giang-hoangnguyen/MM_Control/enclosure/stl/Enclosure_Top_print.stl

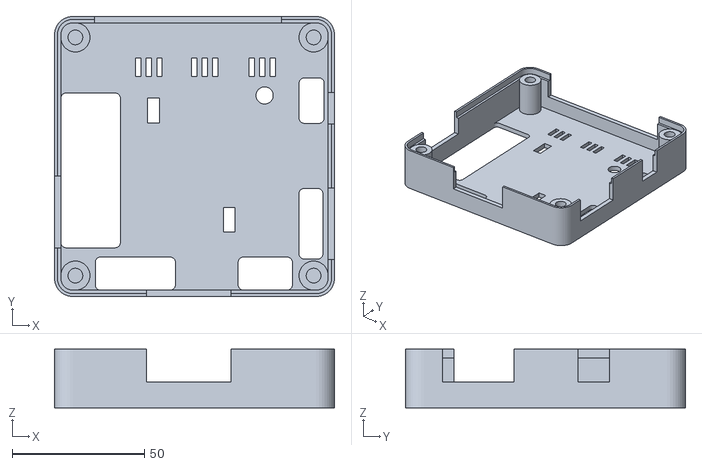
[picture p14: CAD file, 2026-10-25]
enclosure/stl/Enclosure_Top_print.stl
105.8 x 105.8 x 22.2
