giang-hoangnguyen/MM_Control/enclosure/stl/Enclosure_Bottom_print.stl

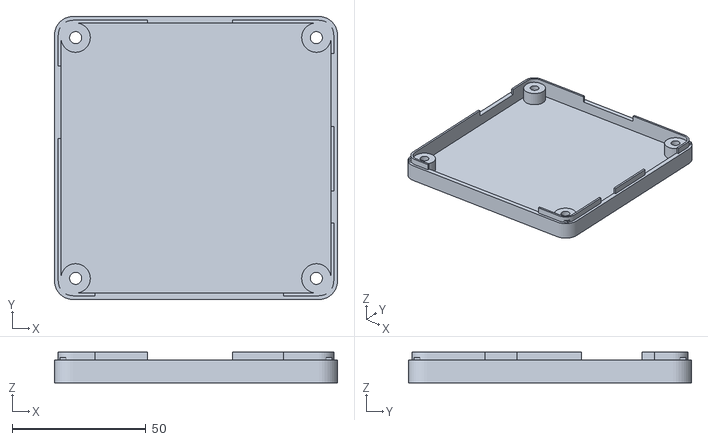
[picture p15: CAD file, 2026-10-24]
enclosure/stl/Enclosure_Bottom_print.stl
105.8 x 105.8 x 11.5
