giang-hoangnguyen/MM_Control/(list of files, cad)

Other CAD files:
enclosure/fusion/MM_Control_Board_v7.f3d
