giang-hoangnguyen/MM_Control/firmware/STS3215_INSTRUCTION.md

# Feetech STS3215 Serial Bus Servo Library Instructions

Please refer to the comprehensive driver guide located at:

👉 [**docs/STS3215_INSTRUCTION.md**](file:///D:/Project_Kicad/MM_Control/firmware/docs/STS3215_INSTRUCTION.md)

### Quick File Map:
- Header: [`Core/Inc/tue_sts3215.h`](file:///D:/Project_Kicad/MM_Control/firmware/Core/Inc/tue_sts3215.h)
- Source: [`Core/Src/tue_sts3215.c`](file:///D:/Project_Kicad/MM_Control/firmware/Core/Src/tue_sts3215.c)
- Memory Table Reference: [`docs/MEMORY_TABLE.md`](file:///D:/Project_Kicad/MM_Control/firmware/docs/MEMORY_TABLE.md)
- Full Instruction Manual: [`docs/STS3215_INSTRUCTION.md`](file:///D:/Project_Kicad/MM_Control/firmware/docs/STS3215_INSTRUCTION.md)
