giang-hoangnguyen/MM_Control/images/enclosure_assembled.png

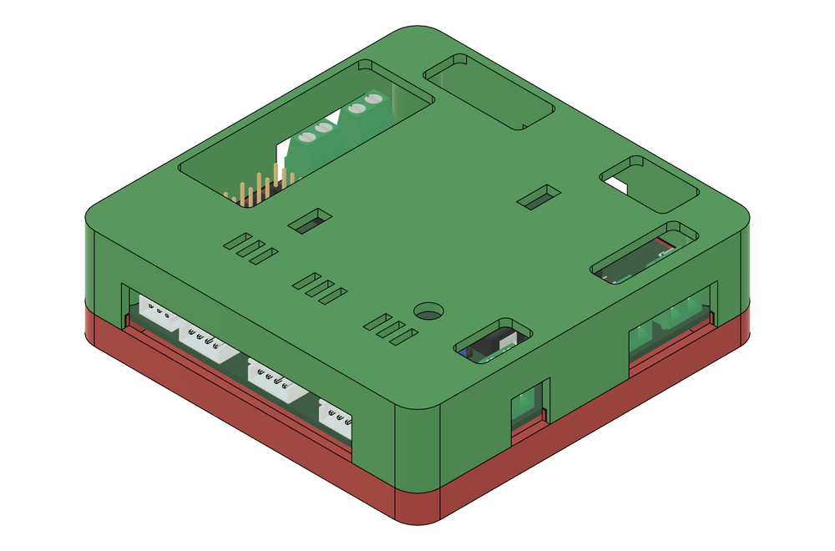
images/enclosure_assembled.png
