giang-hoangnguyen/MM_Control/hardware/schematic/MM_Control_schematic.pdf

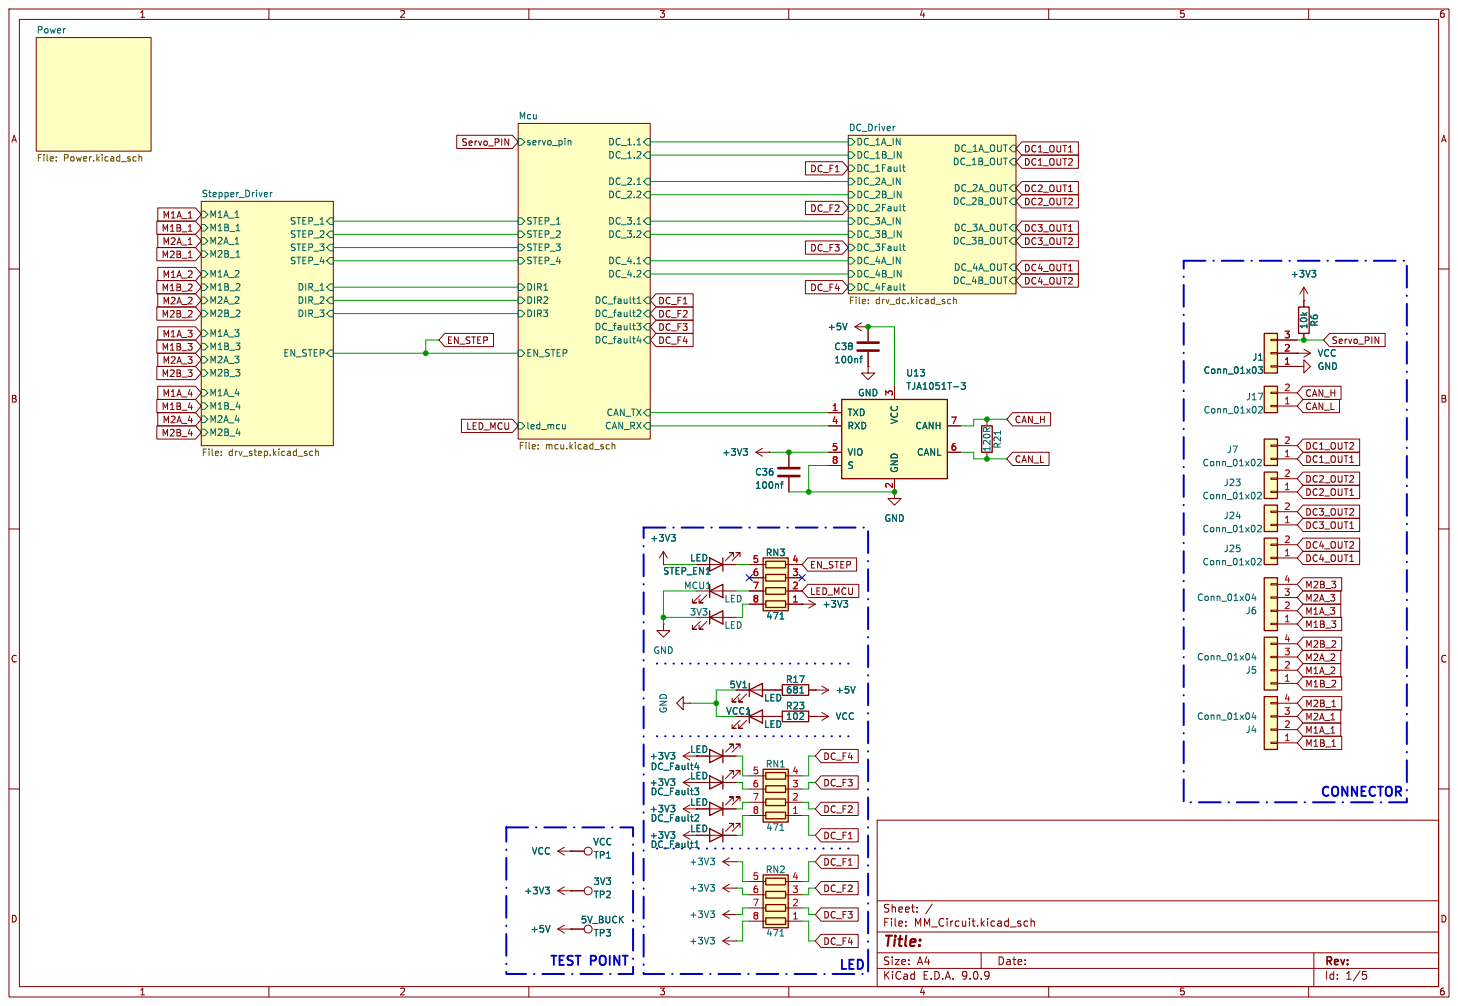
[picture p17: page 1]

CONNECTOR - þÿiÁuþÿkhiÃn 4 con step - þÿiÁuþÿkhiÃn 4 con dc - þÿiÁuþÿkhiÃn 1 con servo (sts3215)

Id: 1/5 Title: File: MM_Circuit.kicad_sch Sheet: /

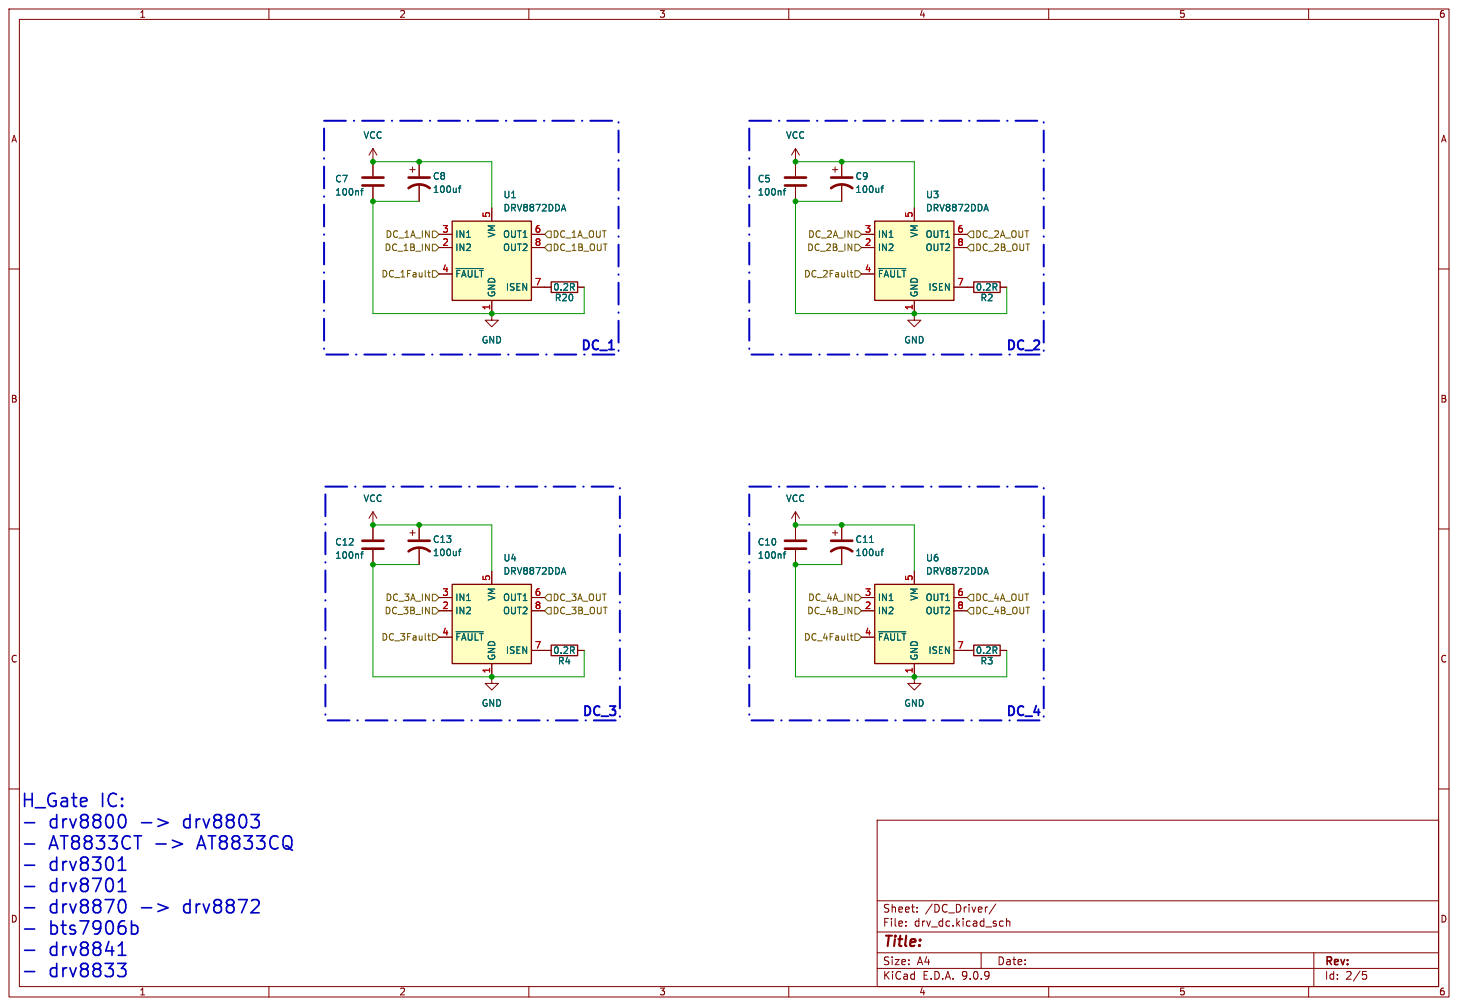
[picture p18: page 2]

Id: 2/5 Title: File: drv_dc.kicad_sch Sheet: /DC_Driver/ GND

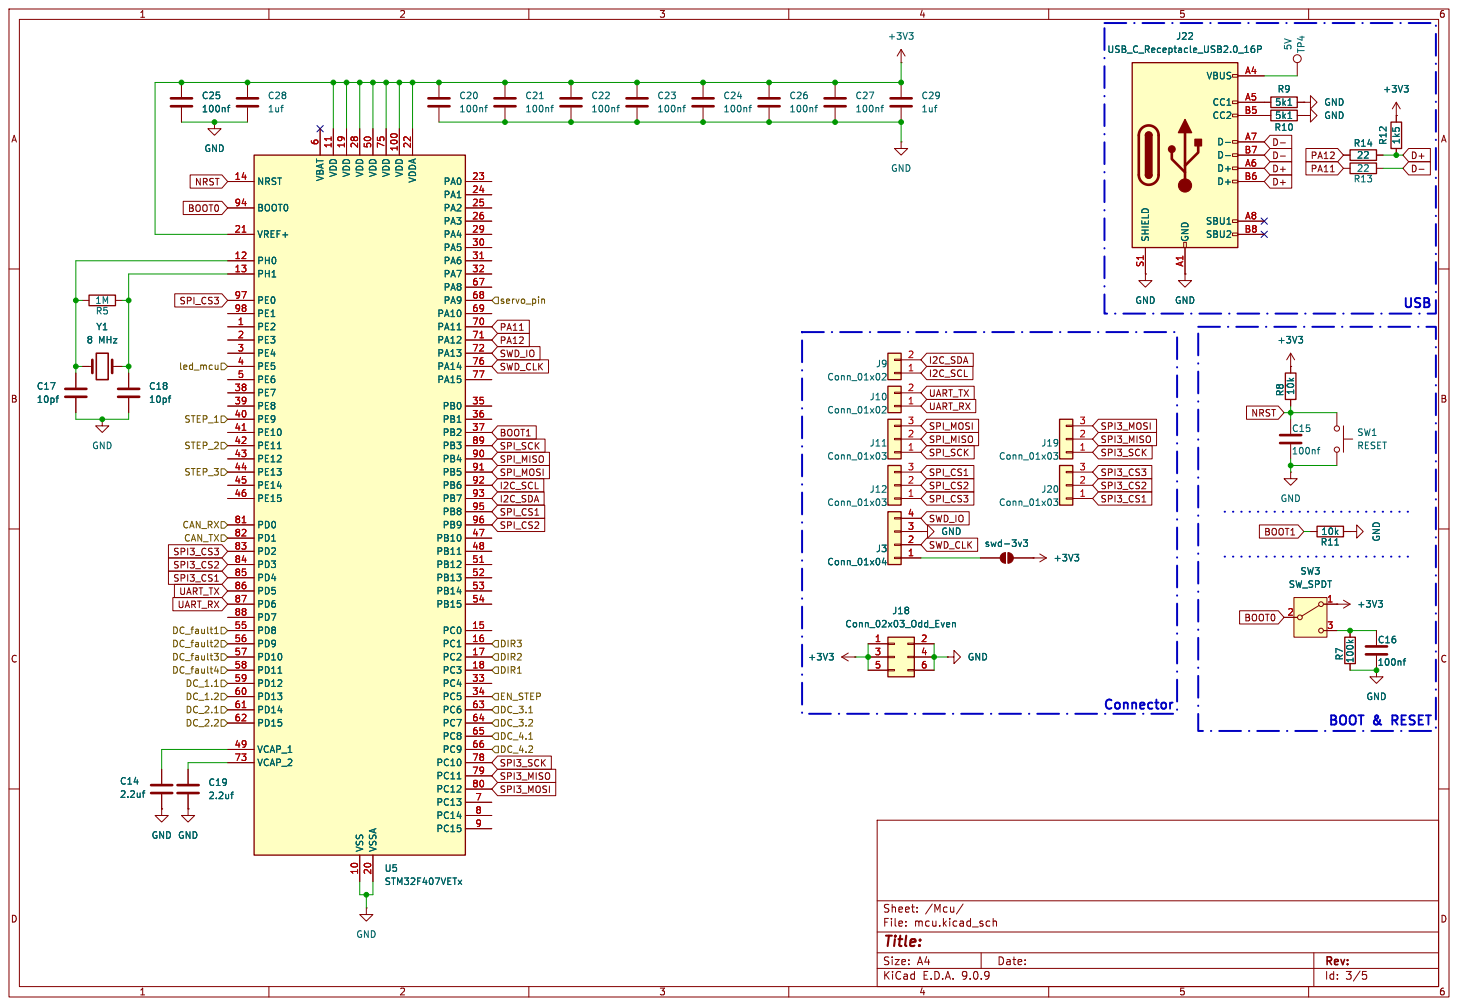
[picture p19: page 3]

Id: 3/5 Title: File: mcu.kicad_sch Sheet: /Mcu/ C14
2.2uf GND GND

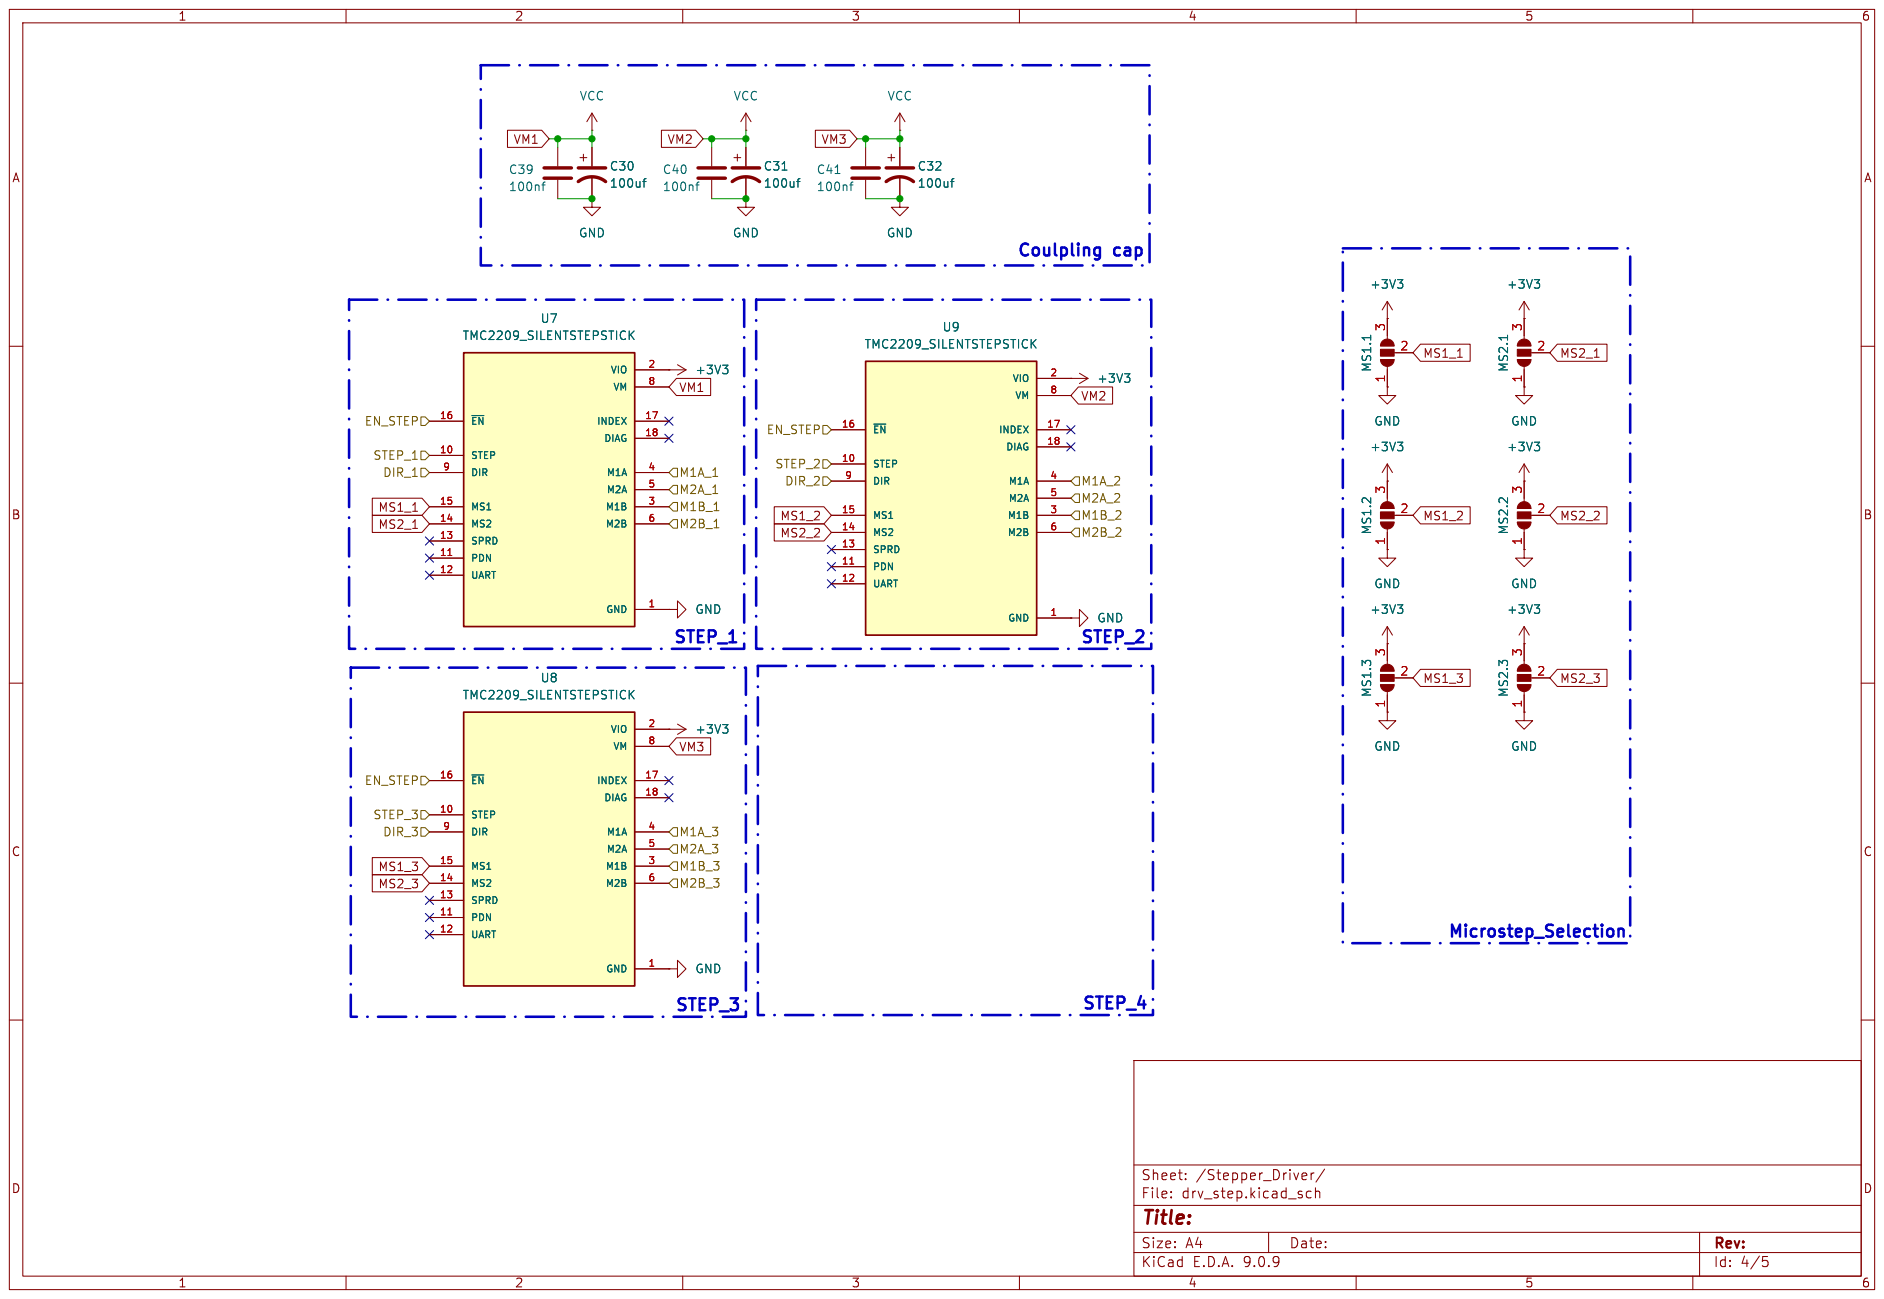
[picture p20: page 4]

Id: 4/5 Title: File: drv_step.kicad_sch Sheet: /Stepper_Driver/

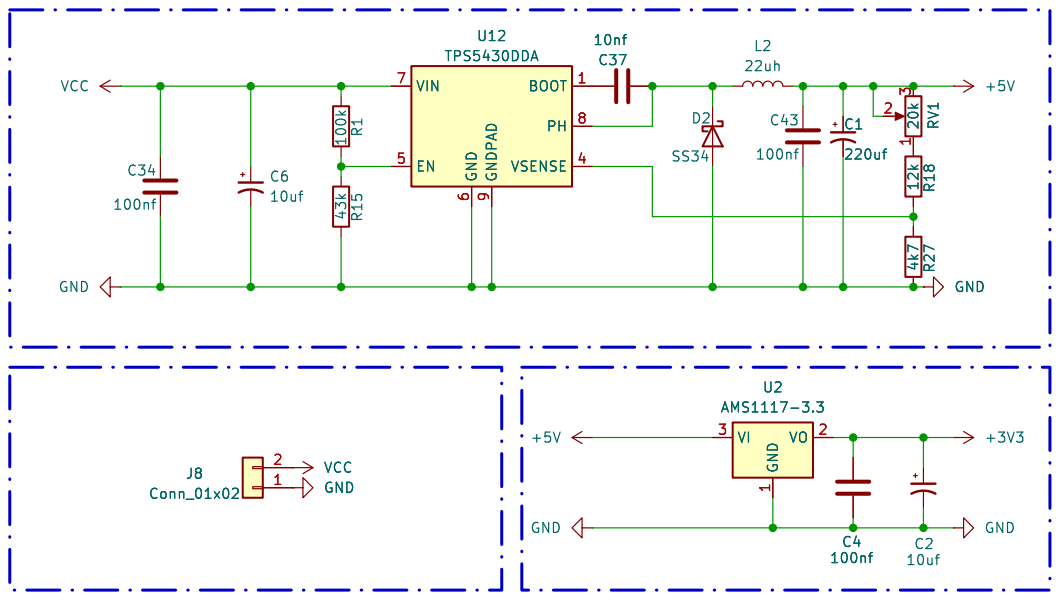
[picture p21: page 5]

Id: 5/5 Title: File: Power.kicad_sch Sheet: /Power/ GND
