giang-hoangnguyen/MM_Control/hardware/MM_Control.kicad_pcb

## KiCad design hardware/MM_Control.kicad_pcb (continued)

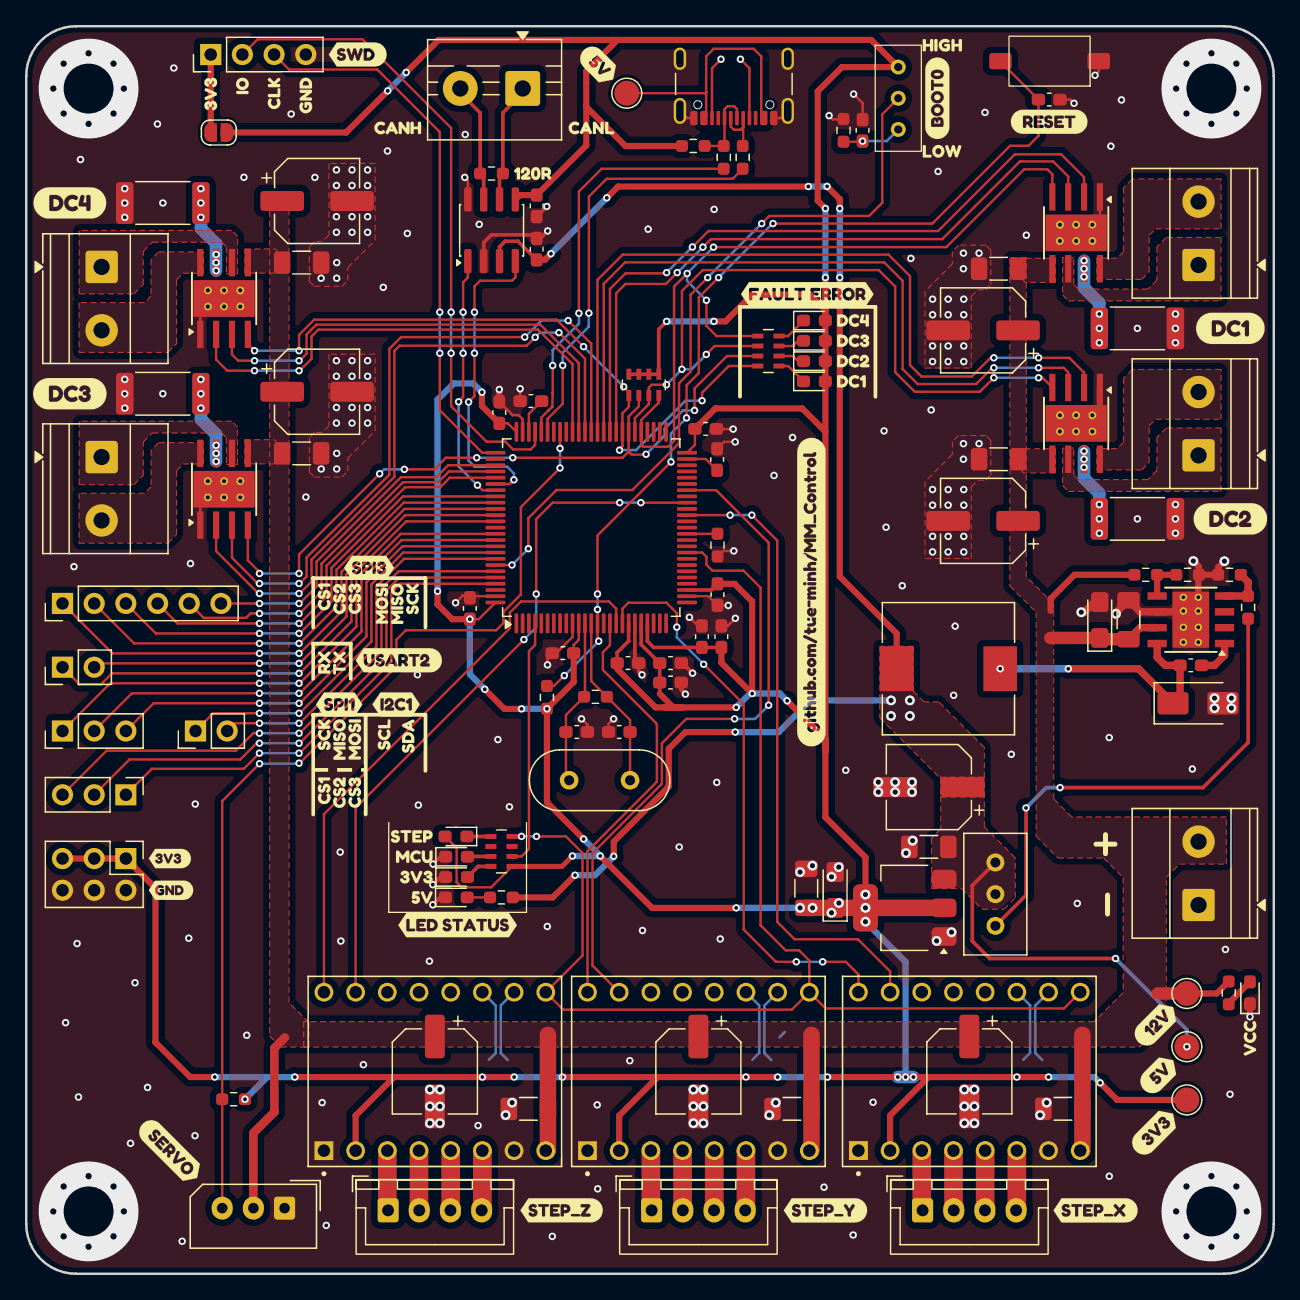
[picture p28: board MM_Control.kicad_pcb from above]

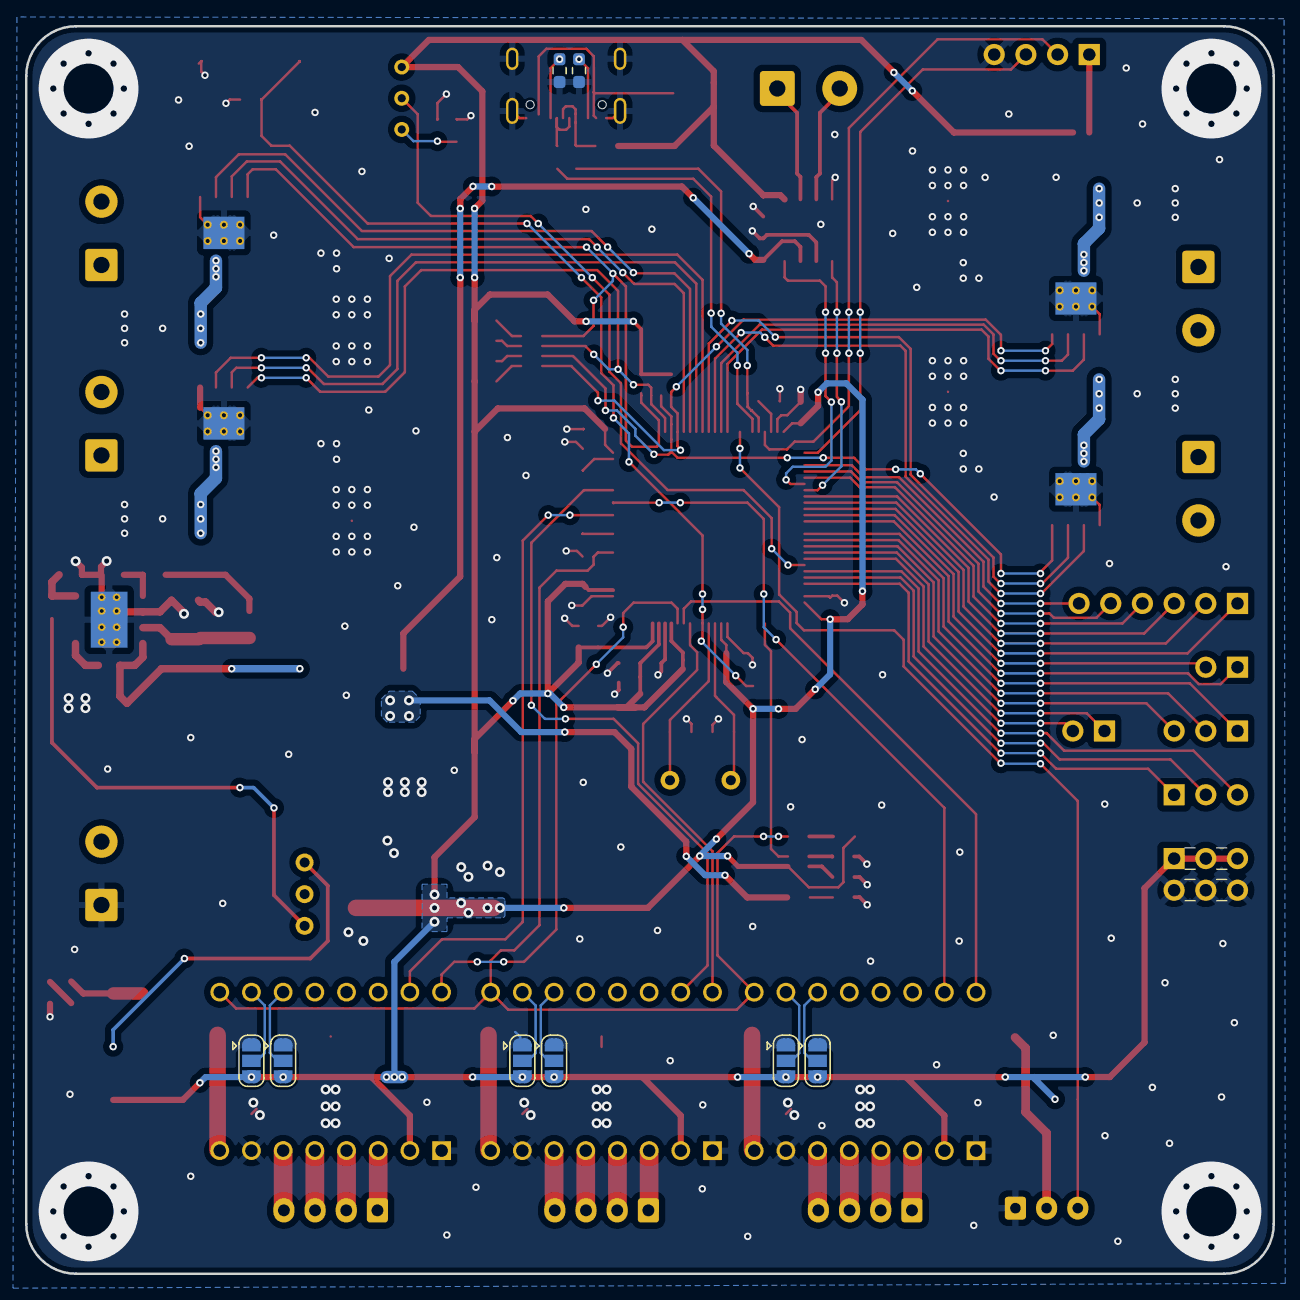
[picture p29: board MM_Control.kicad_pcb from below]

Board: 2 copper layers, 100.0 x 100.0 mm, 176 parts (8 on the bottom side), 107 nets.

Other parts of the board:
kibuzzard-6AAE0E6C: G***; kibuzzard-6AAE0E6C
kibuzzard-6AAE0ECB: G***; kibuzzard-6AAE0ECB
kibuzzard-6AAE0FD8: G***; kibuzzard-6AAE0FD8
kibuzzard-6AAE0FDE: G***; kibuzzard-6AAE0FDE
kibuzzard-6AAE0FE1: G***; kibuzzard-6AAE0FE1
kibuzzard-6AAE0FE6: G***; kibuzzard-6AAE0FE6
kibuzzard-6AAE10A6: G***; kibuzzard-6AAE10A6
kibuzzard-6AAE11A1: G***; kibuzzard-6AAE11A1
kibuzzard-6AAE11BA: G***; kibuzzard-6AAE11BA
kibuzzard-6AAE11CA: G***; kibuzzard-6AAE11CA
kibuzzard-6AAE12C7: G***; kibuzzard-6AAE12C7
kibuzzard-6AAE12D7: G***; kibuzzard-6AAE12D7
kibuzzard-6AAE12FE: G***; kibuzzard-6AAE12FE
kibuzzard-6AAE70A5: G***; kibuzzard-6AAE70A5
kibuzzard-6AAE70C3: G***; kibuzzard-6AAE70C3
kibuzzard-6AAE72CB: G***; kibuzzard-6AAE72CB
kibuzzard-6AAE75E4: G***; kibuzzard-6AAE75E4
kibuzzard-6AAE75E6: G***; kibuzzard-6AAE75E6
kibuzzard-6AAE76A6: G***; kibuzzard-6AAE76A6
kibuzzard-6AAE76A8: G***; kibuzzard-6AAE76A8
kibuzzard-6AAE111B: G***; kibuzzard-6AAE111B
kibuzzard-6AAE131B: G***; kibuzzard-6AAE131B
kibuzzard-6AAE131F: G***; kibuzzard-6AAE131F
kibuzzard-6AAE137A: G***; kibuzzard-6AAE137A
kibuzzard-6AAE137D: G***; kibuzzard-6AAE137D
kibuzzard-6AAE712B, kibuzzard-6AAE712B#2: G***; kibuzzard-6AAE712B
kibuzzard-6AAE746A, kibuzzard-6AAE746A#2: G***; kibuzzard-6AAE746A
kibuzzard-6AAE747C, kibuzzard-6AAE747C#2: G***; kibuzzard-6AAE747C
kibuzzard-6AAE748A: G***; kibuzzard-6AAE748A
kibuzzard-6AAE1091: G***; kibuzzard-6AAE1091
kibuzzard-6AAE1124: G***; kibuzzard-6AAE1124
kibuzzard-6AAE1171: G***; kibuzzard-6AAE1171
kibuzzard-6AAE1324: G***; kibuzzard-6AAE1324
kibuzzard-6AAE1368: G***; kibuzzard-6AAE1368
kibuzzard-6AAE1376: G***; kibuzzard-6AAE1376
kibuzzard-6AAE7140: G***; kibuzzard-6AAE7140
kibuzzard-6AAE7148: G***; kibuzzard-6AAE7148
kibuzzard-6AAE7310: G***; kibuzzard-6AAE7310
kibuzzard-6AAE7386: G***; kibuzzard-6AAE7386
kibuzzard-6AAE7481, kibuzzard-6AAE7481#2: G***; kibuzzard-6AAE7481
kibuzzard-6AAE7487: G***; kibuzzard-6AAE7487
kibuzzard-6AAE7490: G***; kibuzzard-6AAE7490
kibuzzard-6AAE7606: G***; kibuzzard-6AAE7606
kibuzzard-6AAE7616: G***; kibuzzard-6AAE7616
kibuzzard-6AAEAE3A: G***; kibuzzard-6AAEAE3A
kibuzzard-6AAEAE3F: G***; kibuzzard-6AAEAE3F
kibuzzard-6AAEAE35: G***; kibuzzard-6AAEAE35
kibuzzard-6AAEAE99: G***; kibuzzard-6AAEAE99
kibuzzard-6AAEAF4A: G***; kibuzzard-6AAEAF4A
kibuzzard-6AAEB0A5: G***; kibuzzard-6AAEB0A5
kibuzzard-6AAEB0A9: G***; kibuzzard-6AAEB0A9
kibuzzard-6AAEB0D3: G***; kibuzzard-6AAEB0D3
kibuzzard-6AAEB075: G***; kibuzzard-6AAEB075
kibuzzard-6AAF97A4: G***; kibuzzard-6AAF97A4
