giang-hoangnguyen/MM_Control/(commit log)

2026-10-23 Initial commit: MM_Control hardware, firmware, enclosure, docs
2026-10-24 Cap nhat vo: cua -Y cho XH cam ngang, nang chan do 1 mm, gop cua hep
    - Dau XH stepper va servo cam ngang tu phia -Y: mo mot cua o vach -Y, bo khoang mo tren mai
    - Chan do cao them 1 mm (DZ), tru nap, lo insert va cua vach dich theo
    - Hai cua cach nhau duoi 10 mm gop thanh mot, khong chua vach
    - Cua so LED mo tren mai, toa do lay tu PCB thay vi doc mesh
2026-10-25 Can khe thong gio giua tan nhiet, xoay XH va servo thanh loai cam ngang
    - Khe thong gio: 3 khe 2 x 7 mm moi tan, can giua tan nhiet TMC2209
    - f3d: than J1, J4, J5, J6 xoay 90 do de mo ra phia -Y, chan kim loai dung lai
    - Dung lai vo va xuat lai STL
2026-10-25 Cap nhat f3d va anh vo theo board moi
    - f3d: nang mo hinh board 1 mm theo chan do, XH va servo cam ngang
    - Dung lai anh vo tach lop va vo lap rap
